kq6up/bygrave/bygrave_outer_cursor_tube.stl

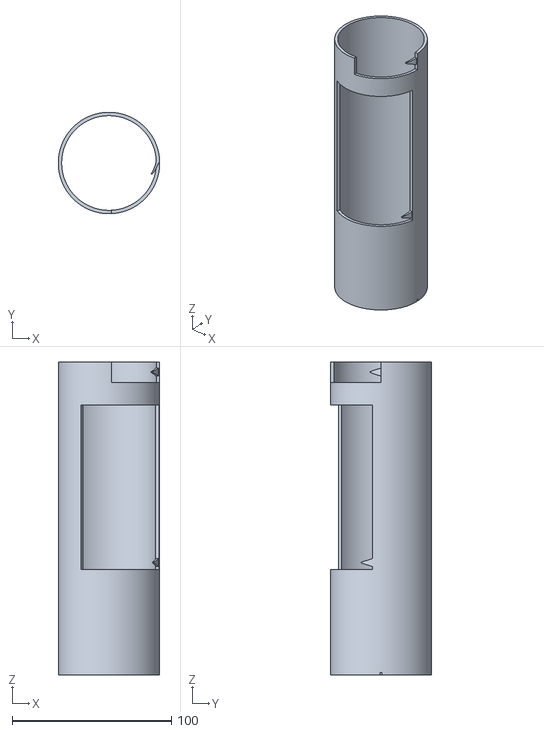
[picture p7: CAD file, 2026-10-28]
bygrave_outer_cursor_tube.stl
63.8 x 63.8 x 196.9
