kq6up/bygrave/bygrave_ladder_outer.stl

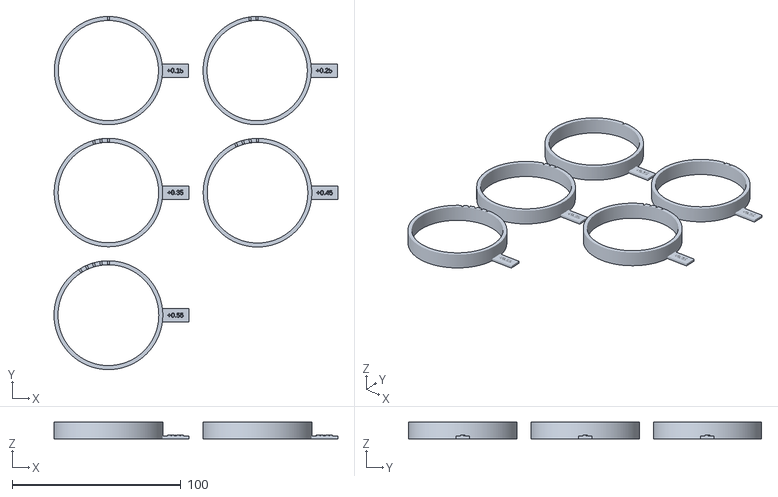
[picture p8: CAD file, 2026-10-28]
bygrave_ladder_outer.stl
168.4 x 209.4 x 10.0
