kq6up/bygrave/bygrave_calibration_rings.stl

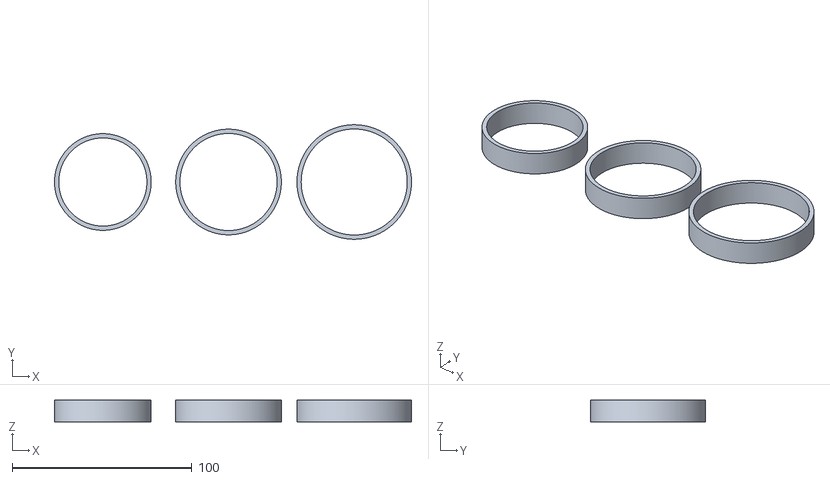
[picture p9: CAD file, 2026-10-28]
bygrave_calibration_rings.stl
198.8 x 63.8 x 12.0
