kq6up/bygrave/bygrave_ladder_middle.stl

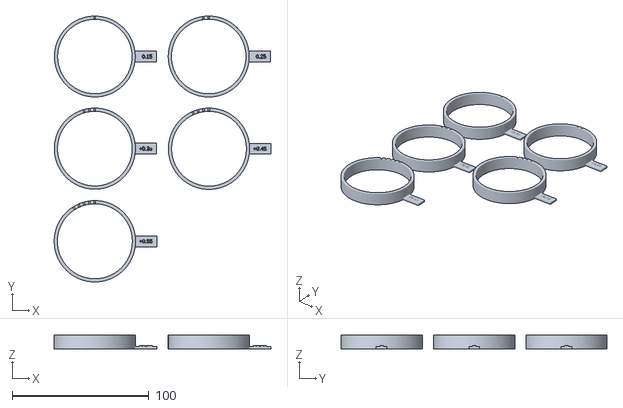
[picture p10: CAD file, 2026-10-28]
bygrave_ladder_middle.stl
158.4 x 194.4 x 10.0
