kq6up/bygrave/bygrave_inner_tube.stl

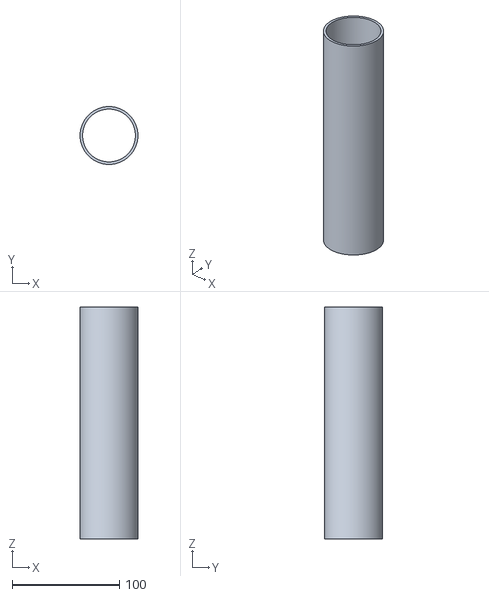
[picture p11: CAD file, 2026-10-28]
bygrave_inner_tube.stl
53.9 x 53.9 x 215.9
