kq6up/bygrave/bygrave_cursor_coupons.stl

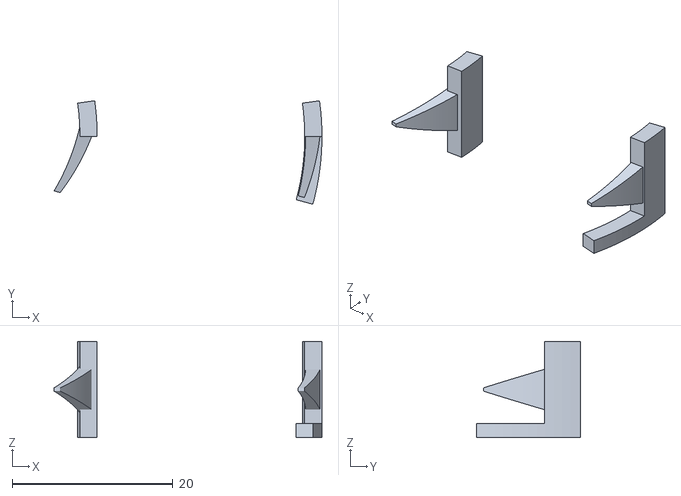
[picture p12: CAD file, 2026-10-28]
bygrave_cursor_coupons.stl
33.4 x 12.9 x 12.0
