kq6up/bygrave/bygrave_middle_tube.stl

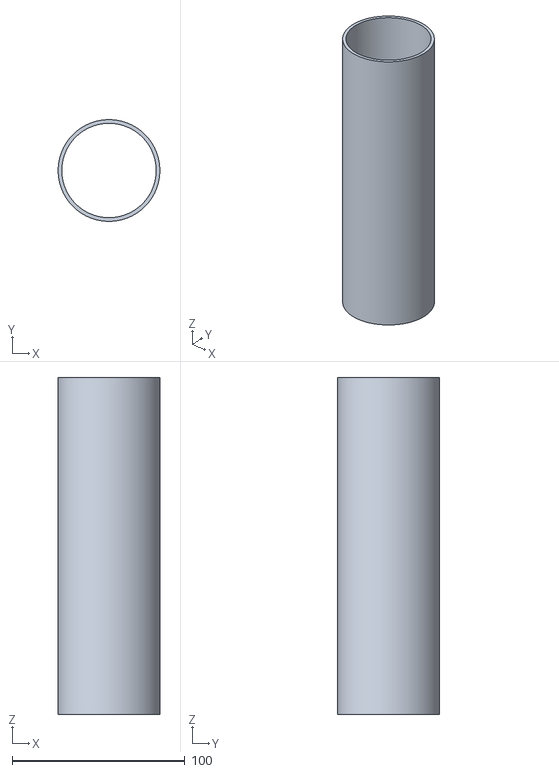
[picture p13: CAD file, 2026-10-28]
bygrave_middle_tube.stl
58.9 x 58.9 x 194.9
