kq6up/bygrave/(commit log)

2026-10-06 Initial 3D-printable Bygrave prototype
    [bygrave_3dprint.scad, bygrave_calibration_rings.stl, bygrave_inner_tube.stl, bygrave_middle_tube.stl, bygrave_outer_cursor_tube.stl]
2026-10-11 Add experimental V1.1 L/S pointers, coupons, CAD renders and clearance checks
    [bygrave_3dprint.scad, bygrave_calibration_rings.stl, bygrave_cursor_coupons.stl, bygrave_inner_tube.stl, bygrave_ladder_middle.stl, bygrave_ladder_outer.stl, bygrave_middle_tube.stl, bygrave_od_check_rings.stl]
